meeplabsdev/halflife-w5/README.md

# Orange Pi Zero 3 HAT
|||
|---|---|

This is a HAT for the Orange Pi Zero 3, which adds some extra features!

# What it is
This project was created for week 5 of [halflife](https://halflife.hackclub.com/)! I designed the schematic and PCB using [KiCad](https://www.kicad.org/), as a hat for the [Orange Pi Zero 3](http://www.orangepi.org/orangepiwiki/index.php/Orange_Pi_Zero_3). It adds the following features:
- New USB C power input, with better filtering and control (limited to 5v, maybe PD/QC in the future)
- Connections for the power, display controller and touch controller of [this](https://www.aliexpress.com/item/1005008698035882.html) display
- Headphone amplifier and 3.5mm jack for the LINEOUT exposed by the 13 pins
- Separate LoRa board that can be used via USB or connected to the HAT internally over SPI/UART
- 1 button and 1 rotary encoder on the front face, 5 buttons on the back face, all controls are along the side
- Support for connecting and using the 5 buttons from the IO board of the aforementioned display as extra inputs
- Almost entirely through-hole components, exceptions are the headphone amplifier, 4 JST connectors, large electrolytic caps and the mosfets
- Also its jam packed

# Hardware
Schematic:



PCB:
|||
|---|---|

# Cost
This is a rough outline of the cost, see [`BOM.csv`](bom.csv) for more details.

| Part | Cost |
| --- | --- |
| [Main HAT](https://jlcpcb.com/) | $4.00 |
| [LoRa board](https://jlcpcb.com/) | $8.00 |
| [LoRa board stencil](https://jlcpcb.com/) | $7.22 |
| [LoRa antenna](https://www.aliexpress.com/item/1005008297942095.html) | $4.75 |
| [All board components](https://lcsc.com/) | $53.77 |
| **Total + Shipping** | **$99.70** |
