meeplabsdev/halflife-w5/BOM.csv

Item | Qty | Supplier | Cost/item | Total Cost | link
LoRa board | 1 | JLCPCB | $8.00 | $8.00 | https://jlcpcb.com/
LoRa board stencil | 1 | JLCPCB | $7.22 | $7.22 | https://jlcpcb.com/
LoRa antenna | 1 | Aliexpress | $4.75 | $4.75 | https://www.aliexpress.com/item/1005008297942095.html
All Board Components | 1 | LCSC | $53.77 | $53.77 | https://lcsc.com/
Main HAT | 1 | JLCPCB | $4.00 | $4.00 | https://jlcpcb.com/
Estimated total shipping | 1 |  |  | $21.96
