meeplabsdev/halflife-w5/lora/production/bom.csv

Designator | Footprint | Quantity | Value | LCSC Part #
C1, C5 | 0402 | 2 | 10uF | C15525
C10, C11, C12, C13, C16, C18, C2, C20, C3, C7, C8, C9 | 0402 | 12 | 100nF | C1525
C14, C15 | 0402 | 2 | 15pF | C1548
C17 | 0603 | 1 | 47nF | C1622
C19 | 0402 | 1 | 47pF | C1567
C21 | 0603 | 1 | 470nF | C1623
C22 | 0402 | 1 | 1nF | C76947
C23 | 0402 | 1 | 18pF | C1549
C24 | 0402 | 1 | 22pF | C1555
C25, C26, C27, C28, C29, C30 | 0402 | 6 | 10pF | C32949
C4, C6 | 0402 | 2 | 1uF | C52923
CN1 | C160409_CONN-SMD_10P-P1_00_SM10B-SRSS-TB-LF-SN | 1 | SM10B-SRSS-TB (LF)(SN) | C160409
FB1 | 0402 | 1 | FerriteBead_Small | C85815
L1 | 0402 | 1 | 47nH | C27151
L2 | 0603 | 1 | 15uH | C57838
L3 | C7434807_FILTER-SMD_10P-L2_0-W1_3-BL | 1 | 0900FM15K0039001E | C7434807
L4 | 0402 | 1 | 9.1nH | C113059
R1 | 0402 | 1 | 10k | C60490
R2, R3 | 0402 | 2 | 22 | C114765
R4, R5 | 0402 | 2 | 1k | C11702
R6 | 0402 | 1 | 100 | C25076
U1 | C6186_SOT-223-3_L6_5-W3_4-P2_30-LS7_0-BR | 1 | AMS1117-3.3 | C6186
U10 | QFN-24-1EP_4x4mm_P0.5mm_EP2.6x2.6mm | 1 | SX1262IMLTRT | C191341
U11 | C470892_SC-70-6_L2_2-W1_3-P0_65-LS2_1-BL | 1 | PE4259-63 | C470892
U12 | C5137195_IPEX-SMD_BWIPX-1-001E | 1 | BWU.FL-IPEX1 | C5137195
U2 | QFN-56-1EP_7x7mm_P0.4mm_EP3.2x3.2mm | 1 | RP2040 | C2040
U9 | C97521_SOIC-8_L5_3-W5_3-P1_27-LS8_0-BL | 1 | W25Q128JVSIQTR | C97521
USB1 | C404969_MICRO-USB-SMD_MICROXNJ_1 | 1 | MICROXNJ | C404969
Y1 | Crystal_SMD_3225-4Pin_3.2x2.5mm | 1 | 12MHz | C9002
Y2 | Crystal_SMD_2016-4Pin_2.0x1.6mm | 1 | 32MHz | C2965582
