meeplabsdev/halflife-w5/hat/production/bom.csv

Designator | Footprint | Quantity | Value | LCSC Part #
C1, C3 | CP_Elec_4x5.4 | 2 | 0.39uF | C22387960
C2, C4 | CP_Elec_8x10.5 | 2 | 330uF | C335985
C5 | CP_Elec_4x5.4 | 1 | 1uF | C72491
C6 | C_Disc_D7.5mm_W4.4mm_P5.00mm | 1 | 0.1uF | C52140108
C7, C8 | C_Disc_D5.1mm_W3.2mm_P5.00mm | 2 | 10uF | C2761740
CN1, CN4 | C160409_CONN-SMD_10P-P1_00_SM10B-SRSS-TB-LF-SN | 2 | SM10B-SRSS-TB (LF)(SN) | C160409
CN2 | C160404_CONN-SMD_4P-P1_00_SM04B-SRSS-TB-LF-SN | 1 | SM04B-SRSS-TB (LF)(SN) | C160404
Q1, Q2, Q3, Q4, Q5 | C50087708_SOT-23-3_L2_9-W1_3-P1_90-LS2_4-BR | 5 | SL3420 | C50087708
R1, R2 | R_Axial_DIN0207_L6.3mm_D2.5mm_P10.16mm_Horizontal | 2 | 5.1k | C714010
R10, R12, R14, R16, R18, R7, R8 | R_Axial_DIN0207_L6.3mm_D2.5mm_P10.16mm_Horizontal | 7 | 100k | C2843019
R11, R13, R15, R17, R9 | R_Axial_DIN0207_L6.3mm_D2.5mm_P10.16mm_Horizontal | 5 | 100 | C385440
R3, R5 | R_Axial_DIN0207_L6.3mm_D2.5mm_P10.16mm_Horizontal | 2 | 20k | C119353
R4, R6 | R_Axial_DIN0207_L6.3mm_D2.5mm_P10.16mm_Horizontal | 2 | 30k | C129921
SW1 | C7507433_SW-TH_HX-MSK-22D18G4-051 | 1 | MSK-22D18G4 051 | C7507433
SW2 | C470753_SW-TH_EC11XXXXXXXX | 1 | EC11E09244AQ | C470753
TP1, TP2, TP3, TP4, TP5, TP6 | SolderWirePad_1x01_SMD_1.5x3mm | 6 | TestPoint
U10, U5, U6, U7, U8, U9 | C5369123_SW-TH_4P-L4_5-W4_5-P3_00-LS5_0 | 6 | TS4550CJ 160GF 022 | C5369123
U2 | C189895_CONN-SMD_4P-P1_25_SM04B-GHS-TB-LF-SN | 1 | SM04B-GHS-TB(LF)(SN) | C189895
U3 | C18185602_AUDIO-TH_PJ-320A-4P-DIP | 1 | PJ-320A-4P DIP | C18185602
U4 | C141374_SOIC-8_L4_9-W3_9-P1_27-LS6_0-BL-2 | 1 | LM4808MX/NOPB | C141374
USB1 | C36936564_USB-C-TH_UC23-0B16F00P11 | 1 | UC23-0B16F00P11 | C36936564
