meeplabsdev/halflife-w5/lora/lora.kicad_pcb

## KiCad design lora/lora.kicad_pcb (2026-11-08)

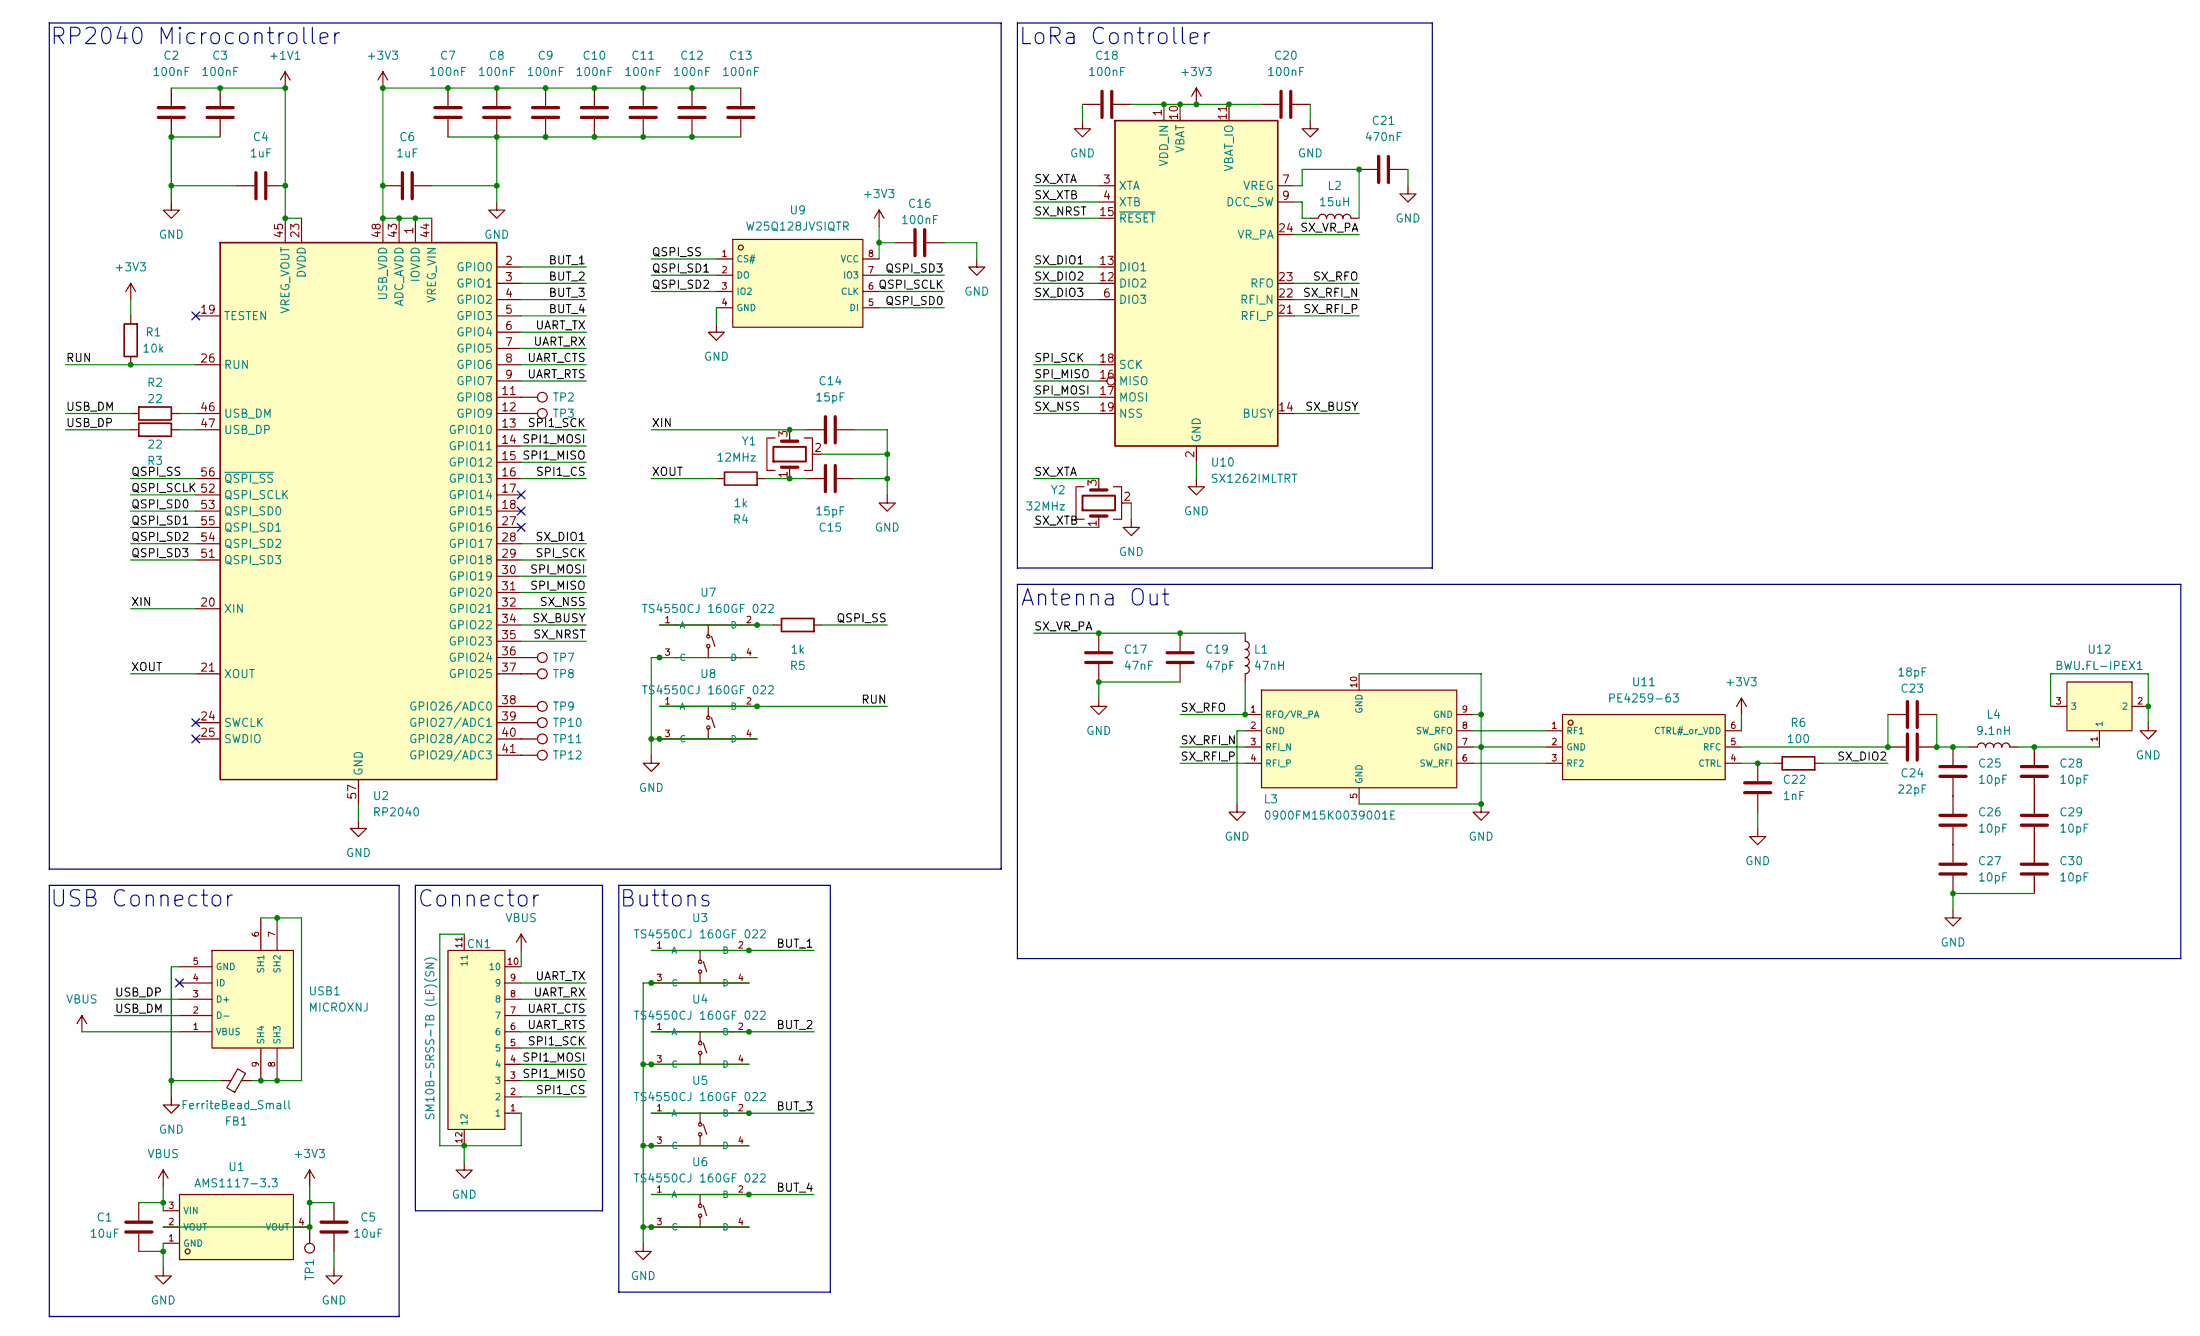
[picture p1: schematic lora.kicad_sch]

Parts:
C1, C5: 10uF; C_0402_1005Metric; LCSC C15525
C2, C3, C7, C8, C9, C10, C11, C12, C13, C16, C18, C20: 100nF; C_0402_1005Metric; LCSC C1525
C4, C6: 1uF; C_0402_1005Metric; LCSC C52923
C14, C15: 15pF; C_0402_1005Metric; LCSC C1548
C17: 47nF; C_0603_1608Metric; LCSC C1622
C19: 47pF; C_0402_1005Metric; LCSC C1567
C21: 470nF; C_0603_1608Metric; LCSC C1623
C22: 1nF; C_0402_1005Metric; LCSC C76947
C23: 18pF; C_0402_1005Metric; LCSC C1549
C24: 22pF; C_0402_1005Metric; LCSC C1555
C25, C26, C27, C28, C29, C30: 10pF; C_0402_1005Metric; LCSC C32949
CN1: SM10B-SRSS-TB (LF)(SN); C160409_CONN-SMD_10P-P1_00_SM10B-SRSS-TB-LF-SN; LCSC C160409
FB1: FerriteBead_Small; L_0402_1005Metric; LCSC C85815
L1: 47nH; L_0402_1005Metric; LCSC C27151
L2: 15uH; L_0603_1608Metric; LCSC C57838
L3: 0900FM15K0039001E; C7434807_FILTER-SMD_10P-L2_0-W1_3-BL; LCSC C7434807
L4: 9.1nH; L_0402_1005Metric; LCSC C113059
R1: 10k; R_0402_1005Metric; LCSC C60490
R2, R3: 22; R_0402_1005Metric; LCSC C114765
R4, R5: 1k; R_0402_1005Metric; LCSC C11702
R6: 100; R_0402_1005Metric; LCSC C25076
TP1, TP2, TP3, TP7, TP8, TP9, TP10, TP11, TP12: TestPoint; TestPoint_Pad_1.0x1.0mm
U1: AMS1117-3.3; C6186_SOT-223-3_L6_5-W3_4-P2_30-LS7_0-BR; LCSC C6186
U2: RP2040; QFN-56-1EP_7x7mm_P0.4mm_EP3.2x3.2mm; LCSC C2040
U3, U4, U5, U6, U7, U8: TS4550CJ 160GF 022; C5369123_SW-TH_4P-L4_5-W4_5-P3_00-LS5_0; LCSC C5369123
U9: W25Q128JVSIQTR; C97521_SOIC-8_L5_3-W5_3-P1_27-LS8_0-BL; LCSC C97521
U10: SX1262IMLTRT; QFN-24-1EP_4x4mm_P0.5mm_EP2.6x2.6mm; LCSC C191341
U11: PE4259-63; C470892_SC-70-6_L2_2-W1_3-P0_65-LS2_1-BL; LCSC C470892
U12: BWU.FL-IPEX1; C5137195_IPEX-SMD_BWIPX-1-001E; LCSC C5137195
USB1: MICROXNJ; C404969_MICRO-USB-SMD_MICROXNJ_1; LCSC C404969
Y1: 12MHz; Crystal_SMD_3225-4Pin_3.2x2.5mm; LCSC C9002
Y2: 32MHz; Crystal_SMD_2016-4Pin_2.0x1.6mm; LCSC C2965582

Connections:
+1V1: C2.1, C3.1, C4.1, U2.23 (DVDD), U2.45 (VREG_VOUT), U2.50 (DVDD)
+3V3: C5.1, C6.2, C7.1, C8.1, C9.1, C10.1, C11.1, C12.1, C13.1, C16.2, C18.2, C20.1, R1.2, TP1.1 (1_1), U1.2 (VOUT), U1.4 (VOUT), U2.1 (IOVDD), U2.10 (IOVDD), U2.22 (IOVDD), U2.33 (IOVDD), U2.42 (IOVDD), U2.43 (ADC_AVDD), U2.44 (VREG_VIN), U2.48 (USB_VDD), U2.49 (IOVDD), U9.8 (VCC), U10.1 (VDD_IN), U10.10 (VBAT), U10.11 (VBAT_IO), U11.6 (CTRL#_or_VDD)
/BUT_1: U2.2 (GPIO0), U3.1 (A), U3.2 (B)
/BUT_2: U2.3 (GPIO1), U4.1 (A), U4.2 (B)
/BUT_3: U2.4 (GPIO2), U5.1 (A), U5.2 (B)
/BUT_4: U2.5 (GPIO3), U6.1 (A), U6.2 (B)
/QSPI_SCLK: U2.52 (QSPI_SCLK), U9.6 (CLK)
/QSPI_SD0: U2.53 (QSPI_SD0), U9.5 (DI)
/QSPI_SD1: U2.55 (QSPI_SD1), U9.2 (DO)
/QSPI_SD2: U2.54 (QSPI_SD2), U9.3 (IO2)
/QSPI_SD3: U2.51 (QSPI_SD3), U9.7 (IO3)
/QSPI_SS: R5.2, U2.56 (~QSPI_SS), U9.1 (CS#)
/RUN: R1.1, U2.26 (RUN), U8.1 (A), U8.2 (B)
/SPI1_CS: CN1.2, U2.16 (GPIO13)
/SPI1_MISO: CN1.3, U2.15 (GPIO12)
/SPI1_MOSI: CN1.4, U2.14 (GPIO11)
/SPI1_SCK: CN1.5, U2.13 (GPIO10)
/SPI_MISO: U2.31 (GPIO20), U10.16 (MISO)
/SPI_MOSI: U2.30 (GPIO19), U10.17 (MOSI)
/SPI_SCK: U2.29 (GPIO18), U10.18 (SCK)
/SX_BUSY: U2.34 (GPIO22), U10.14 (BUSY)
/SX_DIO1: U2.28 (GPIO17), U10.13 (DIO1)
/SX_DIO2: R6.2, U10.12 (DIO2)
/SX_DIO3: U10.6 (DIO3)
/SX_NRST: U2.35 (GPIO23), U10.15 (~RESET)
/SX_NSS: U2.32 (GPIO21), U10.19 (NSS)
/SX_RFI_N: L3.3 (RFI_N), U10.22 (RFI_N)
/SX_RFI_P: L3.4 (RFI_P), U10.21 (RFI_P)
/SX_RFO: L1.2, L3.1 (RFO/VR_PA), U10.23 (RFO)
/SX_VR_PA: C17.1, C19.1, L1.1, U10.24 (VR_PA)
/SX_XTA: U10.3 (XTA), Y2.3
/SX_XTB: U10.4 (XTB), Y2.1
/UART_CTS: CN1.7, U2.8 (GPIO6)
/UART_RTS: CN1.6, U2.9 (GPIO7)
/UART_RX: CN1.8, U2.7 (GPIO5)
/UART_TX: CN1.9, U2.6 (GPIO4)
/USB_DM: R2.2, USB1.2 (D-)
/USB_DP: R3.2, USB1.3 (D+)
/XIN: C14.2, U2.20 (XIN), Y1.3
/XOUT: R4.1, U2.21 (XOUT)
GND: C1.2, C2.2, C3.2, C4.2, C5.2, C6.1, C7.2, C8.2, C9.2, C10.2, C11.2, C12.2, C13.2, C14.1, C15.1, C16.1, C17.2, C18.1, C19.2, C20.2, C21.2, C22.1, C27.1, C30.1, CN1.1, CN1.11, CN1.12, FB1.1, L3.2 (GND), L3.5 (GND), L3.7 (GND), L3.9 (GND), L3.10 (GND), U1.1 (GND), U2.57 (GND), U3.3 (C), U3.4 (D), U4.3 (C), U4.4 (D), U5.3 (C), U5.4 (D), U6.3 (C), U6.4 (D), U7.3 (C), U7.4 (D), U8.3 (C), U8.4 (D), U9.4 (GND), U10.2 (GND), U10.5 (GND), U10.8 (GND), U10.20 (GND), U10.25 (GND), U11.2 (GND), U12.2, U12.3, USB1.5 (GND), Y1.2 (G), Y1.4 (G), Y2.2 (G), Y2.4 (G)
unnamed: C15.2, R4.2, Y1.1
unnamed: C23.2, C24.2, C25.2, L4.1
unnamed: C25.1, C26.2
unnamed: C26.1, C27.2
unnamed: C28.1, C29.2
unnamed: C28.2, L4.2, U12.1
unnamed: C29.1, C30.2
unnamed: L3.6 (SW_RFI), U11.3 (RF2)
unnamed: L3.8 (SW_RFO), U11.1 (RF1)
unnamed: TP2.1 (1_1), U2.11 (GPIO8)
unnamed: TP3.1 (1_1), U2.12 (GPIO9)
unnamed: TP7.1 (1_1), U2.36 (GPIO24)
unnamed: TP8.1 (1_1), U2.37 (GPIO25)
unnamed: TP9.1 (1_1), U2.38 (GPIO26/ADC0)
unnamed: TP10.1 (1_1), U2.39 (GPIO27/ADC1)
unnamed: TP11.1 (1_1), U2.40 (GPIO28/ADC2)
unnamed: TP12.1 (1_1), U2.41 (GPIO29/ADC3)
unnamed: R2.1, U2.46 (USB_DM)
unnamed: R3.1, U2.47 (USB_DP)
unnamed: R5.1, U7.1 (A), U7.2 (B)
unnamed: L2.1, U10.9 (DCC_SW)
unnamed: C21.1, L2.2, U10.7 (VREG)
unnamed: C22.2, R6.1, U11.4 (CTRL)
unnamed: C23.1, C24.1, U11.5 (RFC)
unnamed: FB1.2, USB1.6 (SH1), USB1.7 (SH2), USB1.8 (SH3), USB1.9 (SH4)
VBUS: C1.1, CN1.10, U1.3 (VIN), USB1.1 (VBUS)

Notes on the sheet:
LoRa Controller
Buttons
Antenna Out
Connector
USB Connector
RP2040 Microcontroller

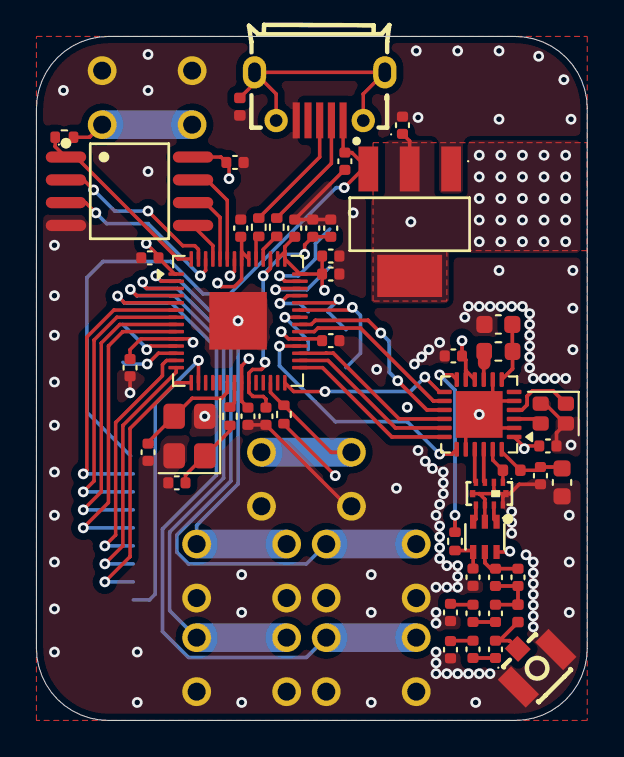
[picture p2: board lora.kicad_pcb from above]

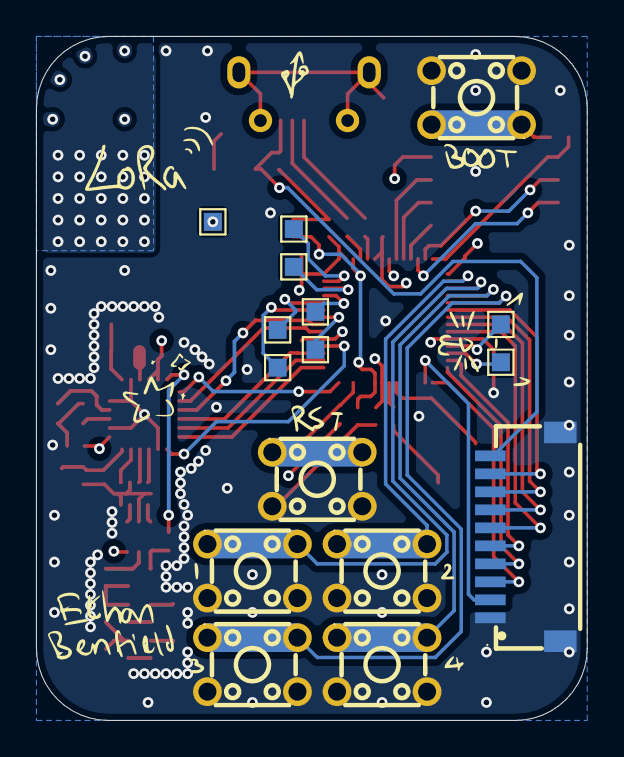
[picture p3: board lora.kicad_pcb from below]

Board: 4 copper layers, 30.6 x 38.0 mm, 66 parts (16 on the bottom side), 66 nets.
