meeplabsdev/halflife-w5/hat/hat.kicad_pcb

## KiCad design hat/hat.kicad_pcb (2026-11-08)

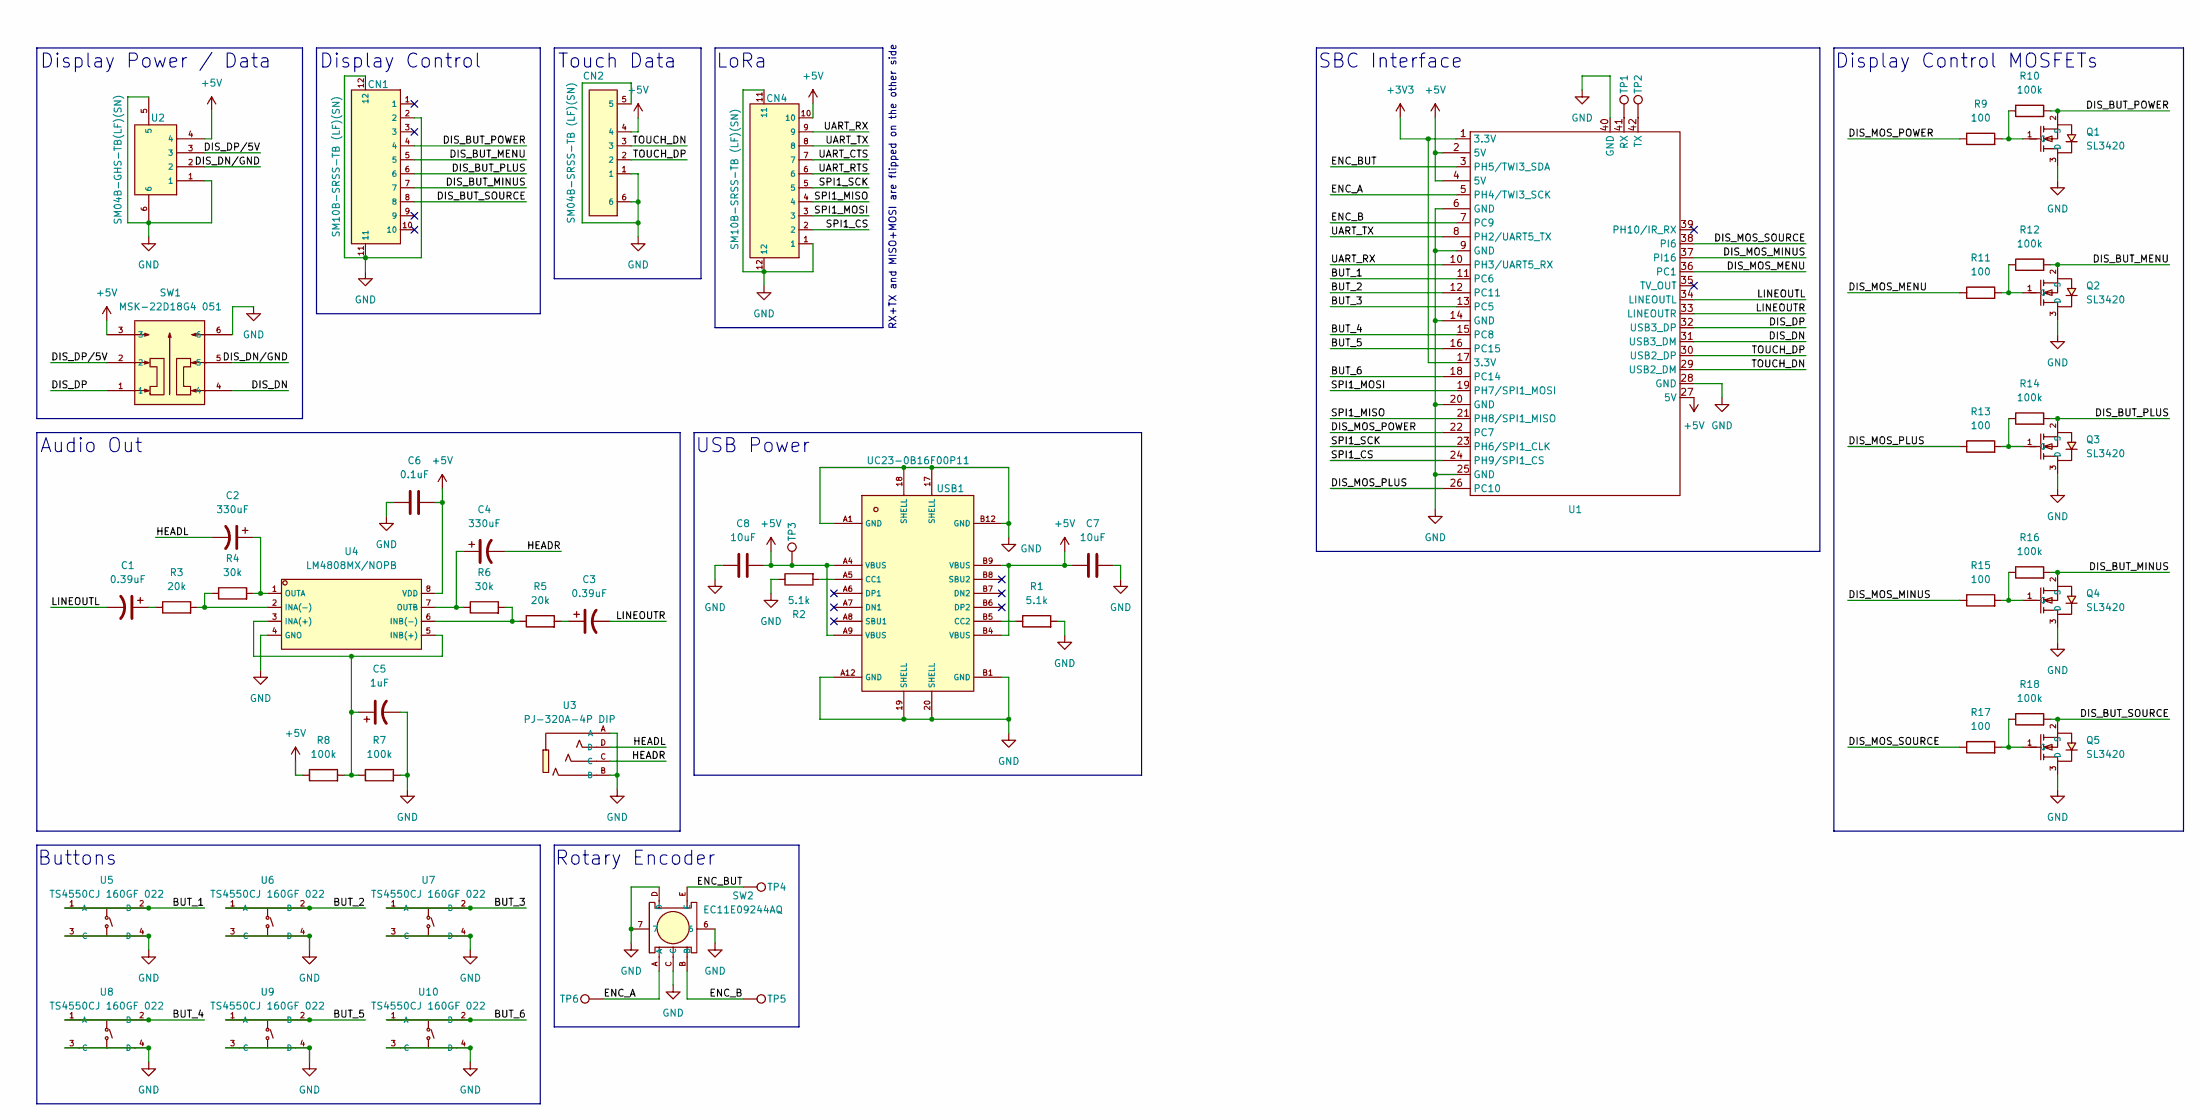
[picture p4: schematic hat.kicad_sch]

Parts:
C1, C3: 0.39uF; CP_Elec_4x5.4; LCSC C22387960
C2, C4: 330uF; CP_Elec_8x10.5; LCSC C335985
C5: 1uF; CP_Elec_4x5.4; LCSC C72491
C6: 0.1uF; C_Disc_D7.5mm_W4.4mm_P5.00mm; LCSC C52140108
C7, C8: 10uF; C_Disc_D5.1mm_W3.2mm_P5.00mm; LCSC C2761740
CN1, CN4: SM10B-SRSS-TB (LF)(SN); C160409_CONN-SMD_10P-P1_00_SM10B-SRSS-TB-LF-SN; LCSC C160409
CN2: SM04B-SRSS-TB (LF)(SN); C160404_CONN-SMD_4P-P1_00_SM04B-SRSS-TB-LF-SN; LCSC C160404
Q1, Q2, Q3, Q4, Q5: SL3420; C50087708_SOT-23-3_L2_9-W1_3-P1_90-LS2_4-BR; LCSC C50087708
R1, R2: 5.1k; R_Axial_DIN0207_L6.3mm_D2.5mm_P10.16mm_Horizontal; LCSC C714010
R3, R5: 20k; R_Axial_DIN0207_L6.3mm_D2.5mm_P10.16mm_Horizontal; LCSC C119353
R4, R6: 30k; R_Axial_DIN0207_L6.3mm_D2.5mm_P10.16mm_Horizontal; LCSC C129921
R7, R8, R10, R12, R14, R16, R18: 100k; R_Axial_DIN0207_L6.3mm_D2.5mm_P10.16mm_Horizontal; LCSC C2843019
R9, R11, R13, R15, R17: 100; R_Axial_DIN0207_L6.3mm_D2.5mm_P10.16mm_Horizontal; LCSC C385440
SW1: MSK-22D18G4 051; C7507433_SW-TH_HX-MSK-22D18G4-051; LCSC C7507433
SW2: EC11E09244AQ; C470753_SW-TH_EC11XXXXXXXX; LCSC C470753
TP1, TP2, TP3, TP4, TP5, TP6: TestPoint; SolderWirePad_1x01_SMD_1.5x3mm
U1: Orange_Pi_Zero_3
U2: SM04B-GHS-TB(LF)(SN); C189895_CONN-SMD_4P-P1_25_SM04B-GHS-TB-LF-SN; LCSC C189895
U3: PJ-320A-4P DIP; C18185602_AUDIO-TH_PJ-320A-4P-DIP; LCSC C18185602
U4: LM4808MX/NOPB; C141374_SOIC-8_L4_9-W3_9-P1_27-LS6_0-BL-2; LCSC C141374
U5, U6, U7, U8, U9, U10: TS4550CJ 160GF 022; C5369123_SW-TH_4P-L4_5-W4_5-P3_00-LS5_0; LCSC C5369123
USB1: UC23-0B16F00P11; C36936564_USB-C-TH_UC23-0B16F00P11; LCSC C36936564

Connections:
+3V3: U1.1 (3.3V), U1.17 (3.3V)
+5V: C6.2, C7.1, C8.2, CN2.4, CN4.10, R8.1, SW1.3, TP3.1 (1_1), U1.2 (5V), U1.4 (5V), U1.27 (5V), U2.4, U4.8 (VDD), USB1.A4 (VBUS), USB1.A9 (VBUS), USB1.B4 (VBUS), USB1.B9 (VBUS)
/BUT_1: U1.11 (PC6), U5.1 (A), U5.2 (B)
/BUT_2: U1.12 (PC11), U6.1 (A), U6.2 (B)
/BUT_3: U1.13 (PC5), U7.1 (A), U7.2 (B)
/BUT_4: U1.15 (PC8), U8.1 (A), U8.2 (B)
/BUT_5: U1.16 (PC15), U9.1 (A), U9.2 (B)
/BUT_6: U1.18 (PC14), U10.1 (A), U10.2 (B)
/DIS_BUT_MENU: CN1.5, Q2.2 (S), R12.2
/DIS_BUT_MINUS: CN1.7, Q4.2 (S), R16.2
/DIS_BUT_PLUS: CN1.6, Q3.2 (S), R14.2
/DIS_BUT_POWER: CN1.4, Q1.2 (S), R10.2
/DIS_BUT_SOURCE: CN1.8, Q5.2 (S), R18.2
/DIS_DN: SW1.4, U1.31 (USB3_DM)
/DIS_DN/GND: SW1.5, U2.2
/DIS_DP: SW1.1, U1.32 (USB3_DP)
/DIS_DP/5V: SW1.2, U2.3
/DIS_MOS_MENU: R11.1, U1.36 (PC1)
/DIS_MOS_MINUS: R15.1, U1.37 (PI16)
/DIS_MOS_PLUS: R13.1, U1.26 (PC10)
/DIS_MOS_POWER: R9.1, U1.22 (PC7)
/DIS_MOS_SOURCE: R17.1, U1.38 (PI6)
/ENC_A: SW2.A, TP6.1 (1_1), U1.5 (PH4/TWI3_SCK)
/ENC_B: SW2.B, TP5.1 (1_1), U1.7 (PC9)
/ENC_BUT: SW2.E, TP4.1 (1_1), U1.3 (PH5/TWI3_SDA)
/HEADL: C2.2, U3.D
/HEADR: C4.2, U3.C
/LINEOUTL: C1.2, U1.34 (LINEOUTL)
/LINEOUTR: C3.2, U1.33 (LINEOUTR)
/SPI1_CS: CN4.2, U1.24 (PH9/SPI1_CS)
/SPI1_MISO: CN4.4, U1.21 (PH8/SPI1_MISO)
/SPI1_MOSI: CN4.3, U1.19 (PH7/SPI1_MOSI)
/SPI1_SCK: CN4.5, U1.23 (PH6/SPI1_CLK)
/TOUCH_DN: CN2.3, U1.29 (USB2_DM)
/TOUCH_DP: CN2.2, U1.30 (USB2_DP)
/UART_CTS: CN4.7
/UART_RTS: CN4.6
/UART_RX: CN4.9, U1.10 (PH3/UART5_RX)
/UART_TX: CN4.8, U1.8 (PH2/UART5_TX)
GND: C5.2, C6.1, C7.2, C8.1, CN1.2, CN1.11, CN1.12, CN2.1, CN2.5, CN2.6, CN4.1, CN4.11, CN4.12, Q1.3 (D), Q2.3 (D), Q3.3 (D), Q4.3 (D), Q5.3 (D), R1.2, R2.1, R7.2, SW1.6, SW2.6, SW2.7, SW2.C, SW2.D, U1.6 (GND), U1.9 (GND), U1.14 (GND), U1.20 (GND), U1.25 (GND), U1.28 (GND), U1.40 (GND), U2.1, U2.5, U2.6, U3.A, U3.B, U4.4 (GNO), U5.3 (C), U5.4 (D), U6.3 (C), U6.4 (D), U7.3 (C), U7.4 (D), U8.3 (C), U8.4 (D), U9.3 (C), U9.4 (D), U10.3 (C), U10.4 (D), USB1.17 (SHELL), USB1.18 (SHELL), USB1.19 (SHELL), USB1.20 (SHELL), USB1.A1 (GND), USB1.A12 (GND), USB1.B1 (GND), USB1.B12 (GND)
unnamed: C1.1, R3.1
unnamed: C3.1, R5.2
unnamed: Q1.1 (G), R9.2, R10.1
unnamed: Q2.1 (G), R11.2, R12.1
unnamed: Q3.1 (G), R13.2, R14.1
unnamed: Q4.1 (G), R15.2, R16.1
unnamed: Q5.1 (G), R17.2, R18.1
unnamed: TP1.1 (1_1), U1.41 (RX)
unnamed: TP2.1 (1_1), U1.42 (TX)
unnamed: C5.1, R7.1, R8.2, U4.3 (INA(+)), U4.5 (INB(+))
unnamed: R3.2, R4.1, U4.2 (INA(-))
unnamed: R5.1, R6.2, U4.6 (INB(-))
unnamed: C2.1, R4.2, U4.1 (OUTA)
unnamed: C4.1, R6.1, U4.7 (OUTB)
unnamed: R2.2, USB1.A5 (CC1)
unnamed: R1.1, USB1.B5 (CC2)

Notes on the sheet:
RX+TX and MISO+MOSI are flipped on the other side
Touch Data
LoRa
Display Control
USB Power
Audio Out
SBC Interface
Display Control MOSFETs
Buttons
Rotary Encoder
Display Power / Data

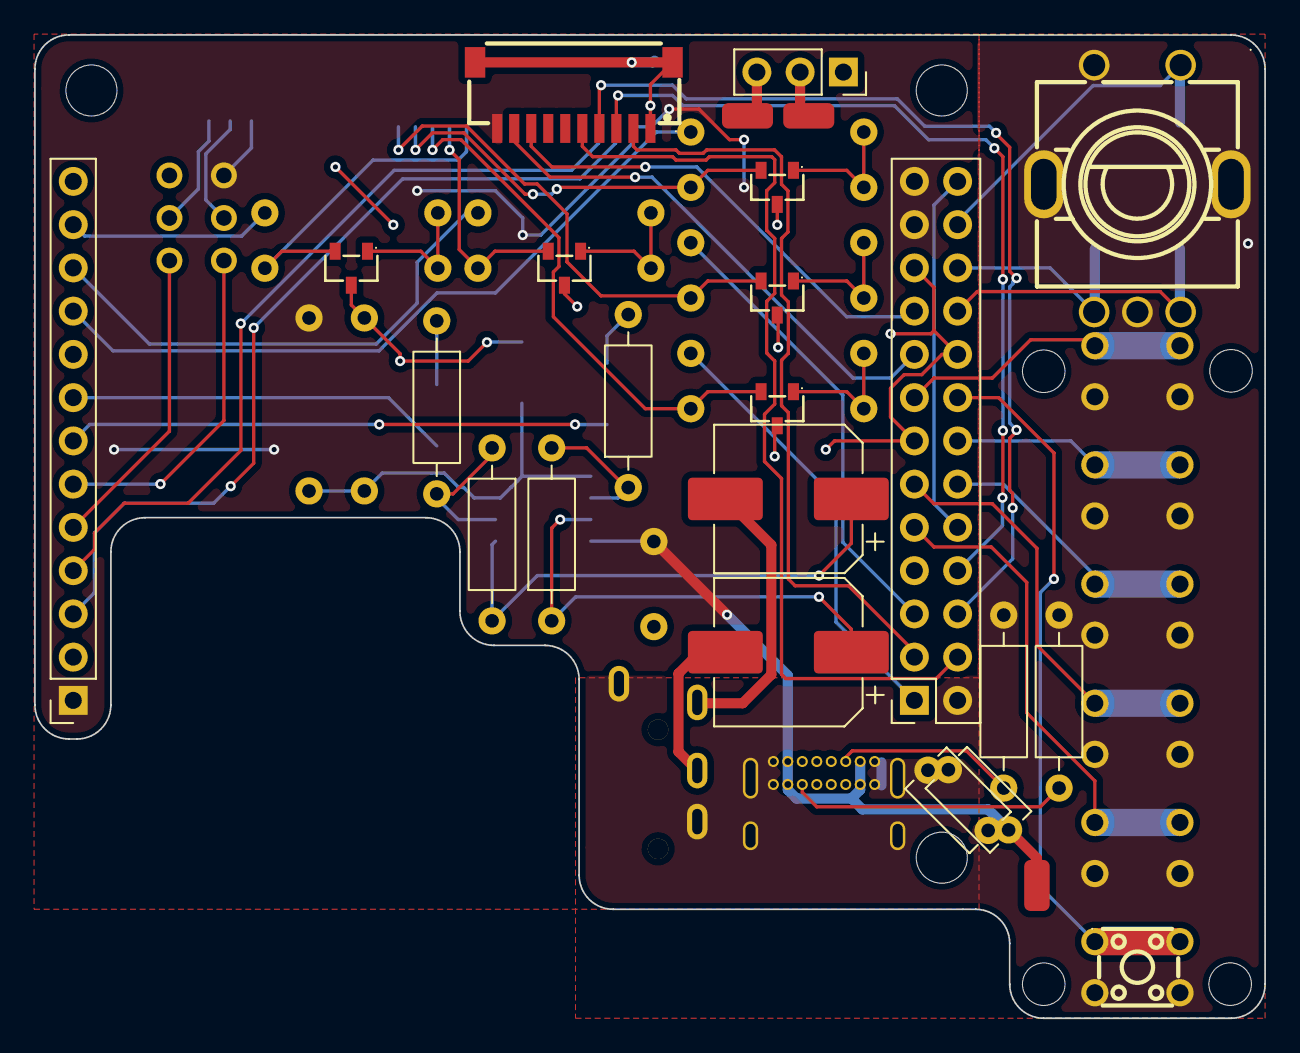
[picture p5: board hat.kicad_pcb from above]

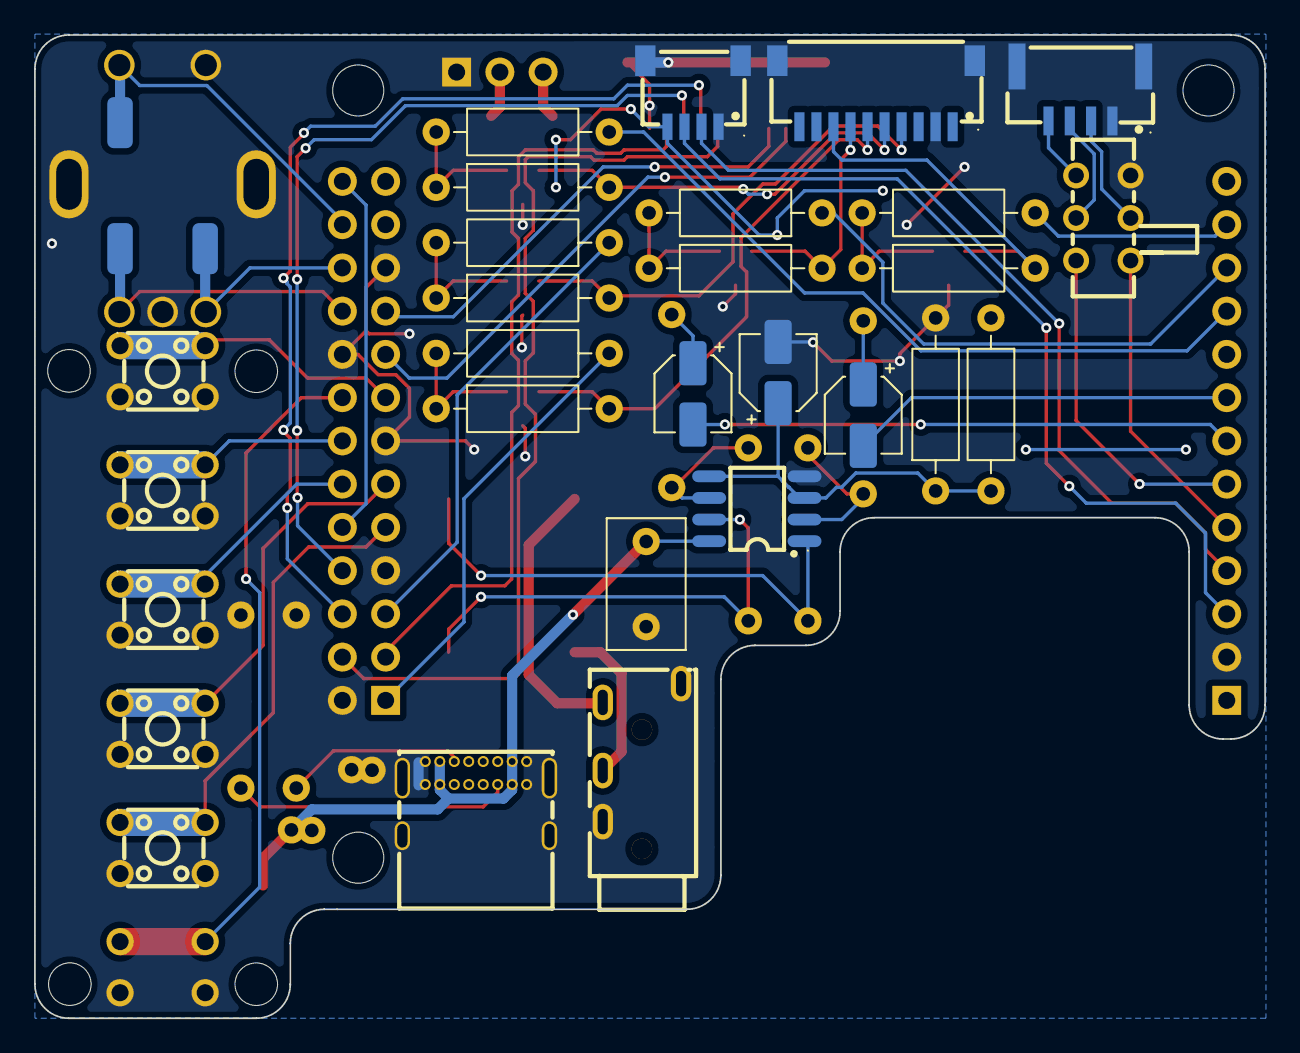
[picture p6: board hat.kicad_pcb from below]

Board: 2 copper layers, 72.2 x 57.8 mm, 53 parts (31 on the bottom side), 54 nets.
