meeplabsdev/halflife-w5/JOURNAL.md

# Orange Pi Zero 3 Hat: devlog

<!-- Generated by Half Life from project rejz83hxqsjrko6m1fjf836q. Edits here are overwritten on the next sync. -->
<!-- Generated: 2026-11-08T12:43:10.372Z -->

> [!NOTE]
> This devlog is mirrored from [Half Life](https://halflife.hackclub.com) ([open the project](https://halflife.hackclub.com/projects/rejz83hxqsjrko6m1fjf836q)). Editing it here will not change the platform's copy, and the next sync overwrites this file.

> adds some more functionality to the orange pi zero 3: - external display control - proper audio output - controls on the side - optional lora connectivity

| Week | Tier | Hours logged | Entries |
| --- | --- | --- | --- |
| Week 5 | Tier 3 | 21.72h | 6 |

## Contents

1. [2026-11-04: Work session](#2026-11-04-work-session)
2. [2026-11-06: Work session](#2026-11-06-work-session)
3. [2026-11-07: Work session](#2026-11-07-work-session)
4. [2026-11-08: Work session](#2026-11-08-work-session)
5. [2026-11-08: Work session](#2026-11-08-work-session)
6. [2026-11-08: Work session](#2026-11-08-work-session)

## Design

### 2026-11-04: Work session

**2.18h**

[Timelapse](https://lookout.hackclub.com/api/media/df912e5b-8285-4f35-99a2-efd154e6c0c4/video.mp4)

### 2026-11-06: Work session

**8.12h**

[Timelapse](https://lookout.hackclub.com/api/media/3bceb79b-f088-44b5-9daa-ba71d1064ec7/video.mp4)

### 2026-11-07: Work session

**3.03h**

[Timelapse](https://lookout.hackclub.com/api/media/6f5ad72d-020c-48ab-9e08-e56e5ccaec87/video.mp4)

### 2026-11-08: Work session

**6.17h**

[Timelapse](https://lookout.hackclub.com/api/media/87a46d36-186e-470d-ac5f-3dba1f3df024/video.mp4)

### 2026-11-08: Work session

**0.52h**

[Timelapse](https://lookout.hackclub.com/api/media/dde2ecd5-67c5-4597-9be5-1dcf35f9915b/video.mp4)

### 2026-11-08: Work session

**1.7h**

[Timelapse](https://lookout.hackclub.com/api/media/f3e384b0-b1e9-4584-863b-3cff20813941/video.mp4)
